mpkendall/prototype-badge/README.md

# prototype-badge
pcb badges for prototype!
