mpkendall/prototype-badge/code/cli/prototype-badge-flasher/README.md

# prototype-badge-flasher

This is a [Ratatui] app generated by the [Simple Template].

[Ratatui]: https://ratatui.rs
[Simple Template]: https://github.com/ratatui/templates/tree/main/simple

## License

Copyright (c) Max Kendall <66796793+mpkendall@users.noreply.github.com>

This project is licensed under the MIT license ([LICENSE] or <http://opensource.org/licenses/MIT>)

[LICENSE]: ./LICENSE
