mpkendall/prototype-badge/hardware/footprints/2-1734839-2.STEP

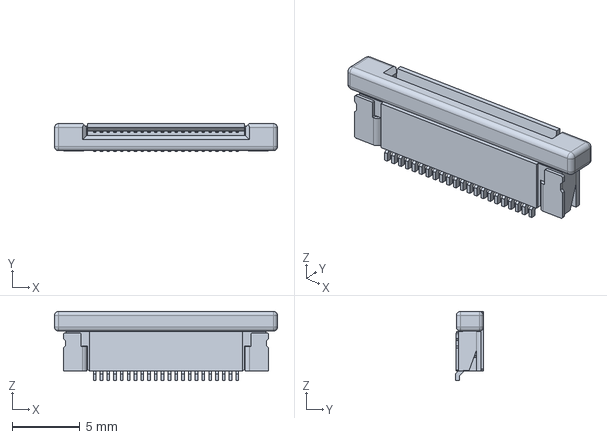
[picture p1: CAD file, 2025-12-05]
hardware/footprints/2-1734839-2.STEP
16.4 x 2.05 x 5.11 mm
