mpkendall/prototype-badge/hardware/footprints/Waveshare 1.54 E ink - Display Folded.stp

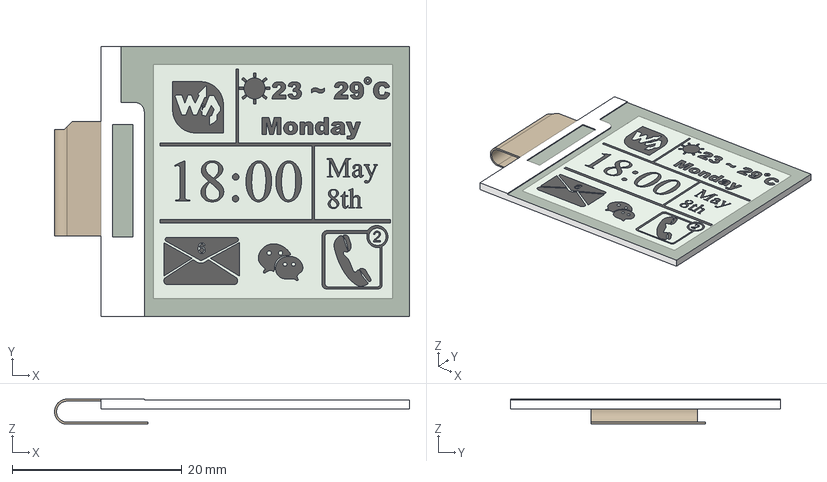
[picture p2: CAD file, 2025-12-05]
hardware/footprints/Waveshare 1.54 E ink - Display Folded.stp
41.8 x 31.8 x 2.92 mm
