mpkendall/prototype-badge/hardware/footprints/NT3H2111W0FHKH.step

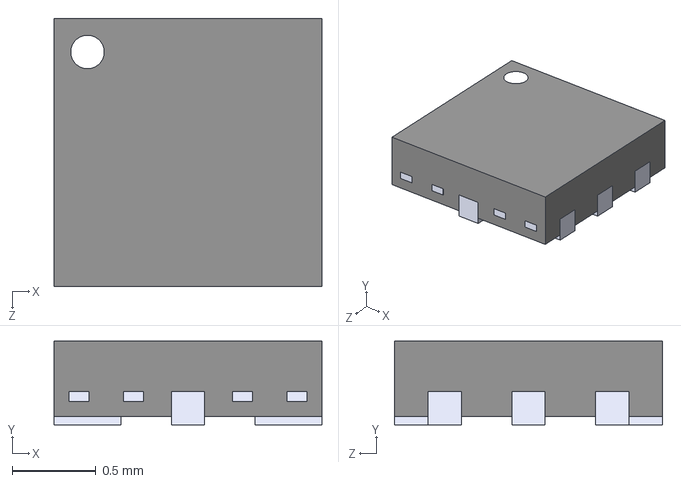
[picture p3: CAD file, 2025-11-28]
hardware/footprints/NT3H2111W0FHKH.step
1.60 x 0.5 x 1.60 mm
