mpkendall/prototype-badge/hardware/prototype-badge.kicad_pcb

## KiCad design hardware/prototype-badge.kicad_pcb (2025-12-01)

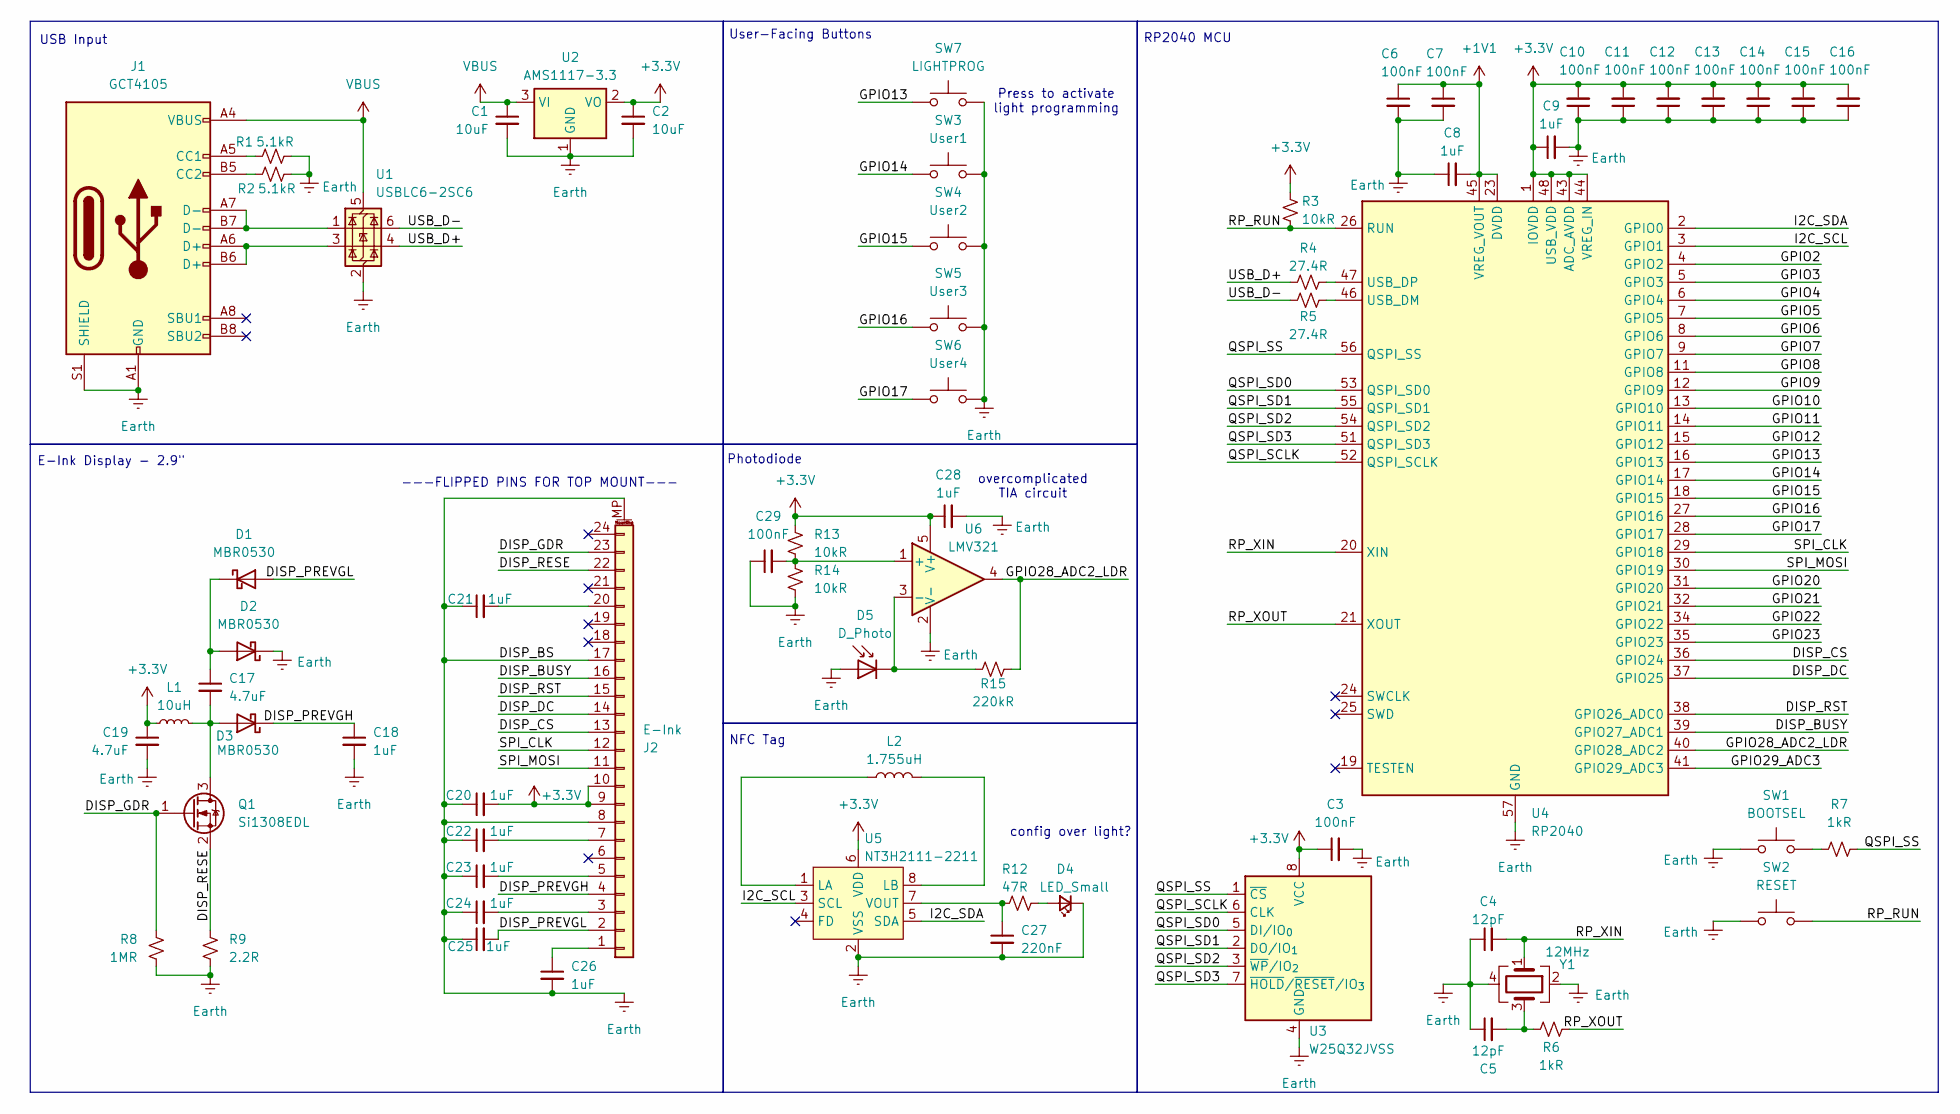
[picture p4: schematic prototype-badge.kicad_sch, Prototype PCB Badges]

Parts:
C1, C2: 10uF; C_0603_1608Metric; LCSC C19702
C3, C6, C7, C10, C11, C12, C13, C14, C15, C16, C29: 100nF; C_0402_1005Metric; LCSC C1525
C4, C5: 12pF; C_0402_1005Metric; LCSC C1547
C8, C9, C18, C20, C21, C22, C23, C24, C25, C26, C28: 1uF; C_0603_1608Metric; LCSC C15849
C17, C19: 4.7uF; C_0603_1608Metric; LCSC C69335
C27: 220nF; C_0402_1005Metric; LCSC C16772
D1, D2, D3: MBR0530; D_SOD-123; LCSC C82046
D4: LED_Small; LED_0603_1608Metric; LCSC C2286
D5: D_Photo; Kingbright_KPS-3227; LCSC C2689207
J1: GCT4105; USB_C_Receptacle_GCT_USB4105-xx-A_16P_TopMnt_Horizontal; LCSC C2760486
J2: E-Ink; TE_2-1734839-4_1x24-1MP_P0.5mm_Horizontal; LCSC C5362165
L1: 10uH; L_APV_ANR4018; LCSC C167808
L2: 1.755uH; nfc-coil-2
Q1: Si1308EDL; SOT-323_SC-70; LCSC C7603347
R1, R2: 5.1kR; R_0402_1005Metric; LCSC C25905
R3, R13, R14: 10kR; R_0402_1005Metric; LCSC C25744
R4, R5: 27.4R; R_0402_1005Metric; LCSC C274349
R6, R7: 1kR; R_0402_1005Metric; LCSC C11702
R8: 1MR; R_0603_1608Metric; LCSC C22935
R9: 2.2R; R_0603_1608Metric; LCSC C22939
R12: 47R; R_0603_1608Metric; LCSC C23182
R15: 220kR; R_0603_1608Metric; LCSC C22961
SW1: BOOTSEL; SW_Tactile_SPST_NO_Straight_CK_PTS636Sx25SMTRLFS; LCSC C318938
SW2: RESET; SW_Tactile_SPST_NO_Straight_CK_PTS636Sx25SMTRLFS; LCSC C318938
SW3: User1; SW_Tactile_SPST_NO_Straight_CK_PTS636Sx25SMTRLFS; LCSC C318938
SW4: User2; SW_Tactile_SPST_NO_Straight_CK_PTS636Sx25SMTRLFS; LCSC C318938
SW5: User3; SW_Tactile_SPST_NO_Straight_CK_PTS636Sx25SMTRLFS; LCSC C318938
SW6: User4; SW_Tactile_SPST_NO_Straight_CK_PTS636Sx25SMTRLFS; LCSC C318938
SW7: LIGHTPROG; SW_Tactile_SPST_NO_Straight_CK_PTS636Sx25SMTRLFS; LCSC C318938
U1: USBLC6-2SC6; SOT-23-6; LCSC C7519
U2: AMS1117-3.3; SOT-223-3_TabPin2; LCSC C18906017
U3: W25Q32JVSS; SOIC-8_5.3x5.3mm_P1.27mm; LCSC C97521
U4: RP2040; QFN-56-1EP_7x7mm_P0.4mm_EP3.2x3.2mm; LCSC C2040
U5: NT3H2111-2211; NT3H2111W0FHKH; LCSC C710403
U6: LMV321; SOT-23-5; LCSC C7972
Y1: 12MHz; Crystal_SMD_3225-4Pin_3.2x2.5mm; LCSC C37635368

Connections:
+1V1: C6.1, C7.1, C8.2, U4.23 (DVDD), U4.45 (VREG_VOUT), U4.50 (DVDD)
+3.3V: C2.1, C3.1, C9.1, C10.2, C11.2, C12.2, C13.2, C14.2, C15.2, C16.2, C19.1, C20.2, C28.1, J2.9, J2.10, L1.1, R3.1, R13.1, U2.2 (VO), U3.8 (VCC), U4.1 (IOVDD), U4.10 (IOVDD), U4.22 (IOVDD), U4.33 (IOVDD), U4.42 (IOVDD), U4.43 (ADC_AVDD), U4.44 (VREG_IN), U4.48 (USB_VDD), U4.49 (IOVDD), U5.6 (VDD), U6.5 (V+)
/DISP_BUSY: J2.16, U4.39 (GPIO27_ADC1)
/DISP_CS: J2.13, U4.36 (GPIO24)
/DISP_DC: J2.14, U4.37 (GPIO25)
/DISP_GDR: J2.23, Q1.1 (G), R8.2
/DISP_PREVGH: C18.1, D3.1 (K), J2.4
/DISP_PREVGL: C25.2, D1.2 (A), J2.2
/DISP_RESE: J2.22, Q1.2 (S), R9.1
/DISP_RST: J2.15, U4.38 (GPIO26_ADC0)
/GPIO2: U4.4 (GPIO2)
/GPIO3: U4.5 (GPIO3)
/GPIO4: U4.6 (GPIO4)
/GPIO5: U4.7 (GPIO5)
/GPIO6: U4.8 (GPIO6)
/GPIO7: U4.9 (GPIO7)
/GPIO8: U4.11 (GPIO8)
/GPIO9: U4.12 (GPIO9)
/GPIO10: U4.13 (GPIO10)
/GPIO11: U4.14 (GPIO11)
/GPIO12: U4.15 (GPIO12)
/GPIO13: SW7.1, U4.16 (GPIO13)
/GPIO14: SW3.1, U4.17 (GPIO14)
/GPIO15: SW4.1, U4.18 (GPIO15)
/GPIO16: SW5.1, U4.27 (GPIO16)
/GPIO17: SW6.1, U4.28 (GPIO17)
/GPIO20: U4.31 (GPIO20)
/GPIO21: U4.32 (GPIO21)
/GPIO22: U4.34 (GPIO22)
/GPIO23: U4.35 (GPIO23)
/GPIO28_ADC2_LDR: R15.1, U4.40 (GPIO28_ADC2), U6.4
/GPIO29_ADC3: U4.41 (GPIO29_ADC3)
/I2C_SCL: U4.3 (GPIO1), U5.3 (SCL)
/I2C_SDA: U4.2 (GPIO0), U5.5 (SDA)
/QSPI_SCLK: U3.6 (CLK), U4.52 (QSPI_SCLK)
/QSPI_SD0: U3.5 (DI/IO_{0}), U4.53 (QSPI_SD0)
/QSPI_SD1: U3.2 (DO/IO_{1}), U4.55 (QSPI_SD1)
/QSPI_SD2: U3.3 (~WP/IO_{2}), U4.54 (QSPI_SD2)
/QSPI_SD3: U3.7 (~HOLD/~RESET/IO_{3}), U4.51 (QSPI_SD3)
/QSPI_SS: R7.2, U3.1 (~CS), U4.56 (QSPI_SS)
/RP_RUN: R3.2, SW2.2, U4.26 (RUN)
/RP_XIN: C4.2, U4.20 (XIN), Y1.1
/RP_XOUT: R6.1, U4.21 (XOUT)
/SPI_CLK: J2.12, U4.29 (GPIO18)
/SPI_MOSI: J2.11, U4.30 (GPIO19)
/USB_D+: R4.1, U1.4 (I/O2)
/USB_D-: R5.2, U1.6 (I/O1)
Earth: C1.2, C2.2, C3.2, C4.1, C5.1, C6.2, C7.2, C8.1, C9.2, C10.1, C11.1, C12.1, C13.1, C14.1, C15.1, C16.1, C18.2, C19.2, C20.1, C21.1, C22.1, C23.1, C24.1, C25.1, C26.2, C27.2, C28.2, C29.1, D2.1 (K), D4.1 (K), D5.2 (A), J1.A1 (GND), J1.A12 (GND), J1.B1 (GND), J1.B12 (GND), J1.S1 (SHIELD), J2.8, J2.17, J2.MP (MountPin), R1.1, R2.2, R8.1, R9.2, R14.2, SW1.1, SW2.1, SW3.2, SW4.2, SW5.2, SW6.2, SW7.2, U1.2 (GND), U2.1 (GND), U3.4 (GND), U4.57 (GND), U5.2 (VSS), U6.2 (V-), Y1.2, Y1.4
unnamed: C5.2, R6.2, Y1.3
unnamed: C17.1, D1.1 (K), D2.2 (A)
unnamed: C17.2, D3.2 (A), L1.2, Q1.3 (D)
unnamed: D4.2 (A), R12.2
unnamed: D5.1 (K), R15.2, U6.3 (-)
unnamed: J1.A5 (CC1), R1.2
unnamed: J1.B5 (CC2), R2.1
unnamed: J1.A6 (D+), J1.B6 (D+), U1.3 (I/O2)
unnamed: J1.A7 (D-), J1.B7 (D-), U1.1 (I/O1)
unnamed: C26.1, J2.1
unnamed: C24.2, J2.3
unnamed: C23.2, J2.5
unnamed: C22.2, J2.7
unnamed: C21.2, J2.20
unnamed: R7.1, SW1.2
unnamed: R5.1, U4.46 (USB_DM)
unnamed: R4.2, U4.47 (USB_DP)
unnamed: L2.1, U5.1 (LA)
unnamed: L2.2, U5.8 (LB)
unnamed: C27.1, R12.1, U5.7 (VOUT)
unnamed: C29.2, R13.2, R14.1, U6.1 (+)
VBUS: C1.1, J1.A4 (VBUS), J1.A9 (VBUS), J1.B4 (VBUS), J1.B9 (VBUS), U1.5 (VBUS), U2.3 (VI)

Notes on the sheet:
User-Facing Buttons
---FLIPPED PINS FOR TOP MOUNT---
Photodiode
Press to activate light programming
E-Ink Display - 2.9"
NFC Tag
USB Input
RP2040 MCU
overcomplicated TIA circuit
config over light?

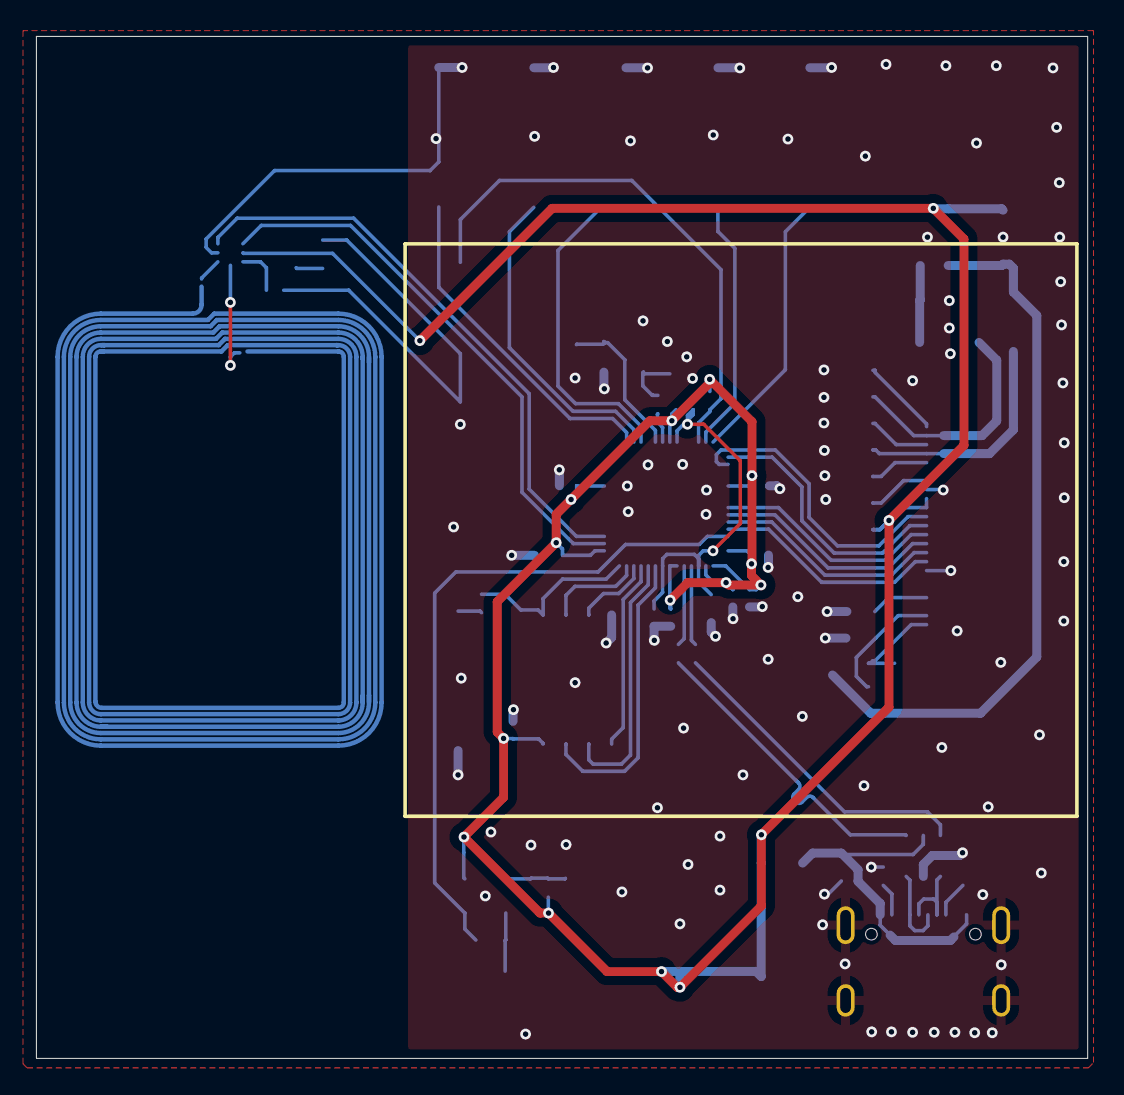
[picture p5: board prototype-badge.kicad_pcb from above]

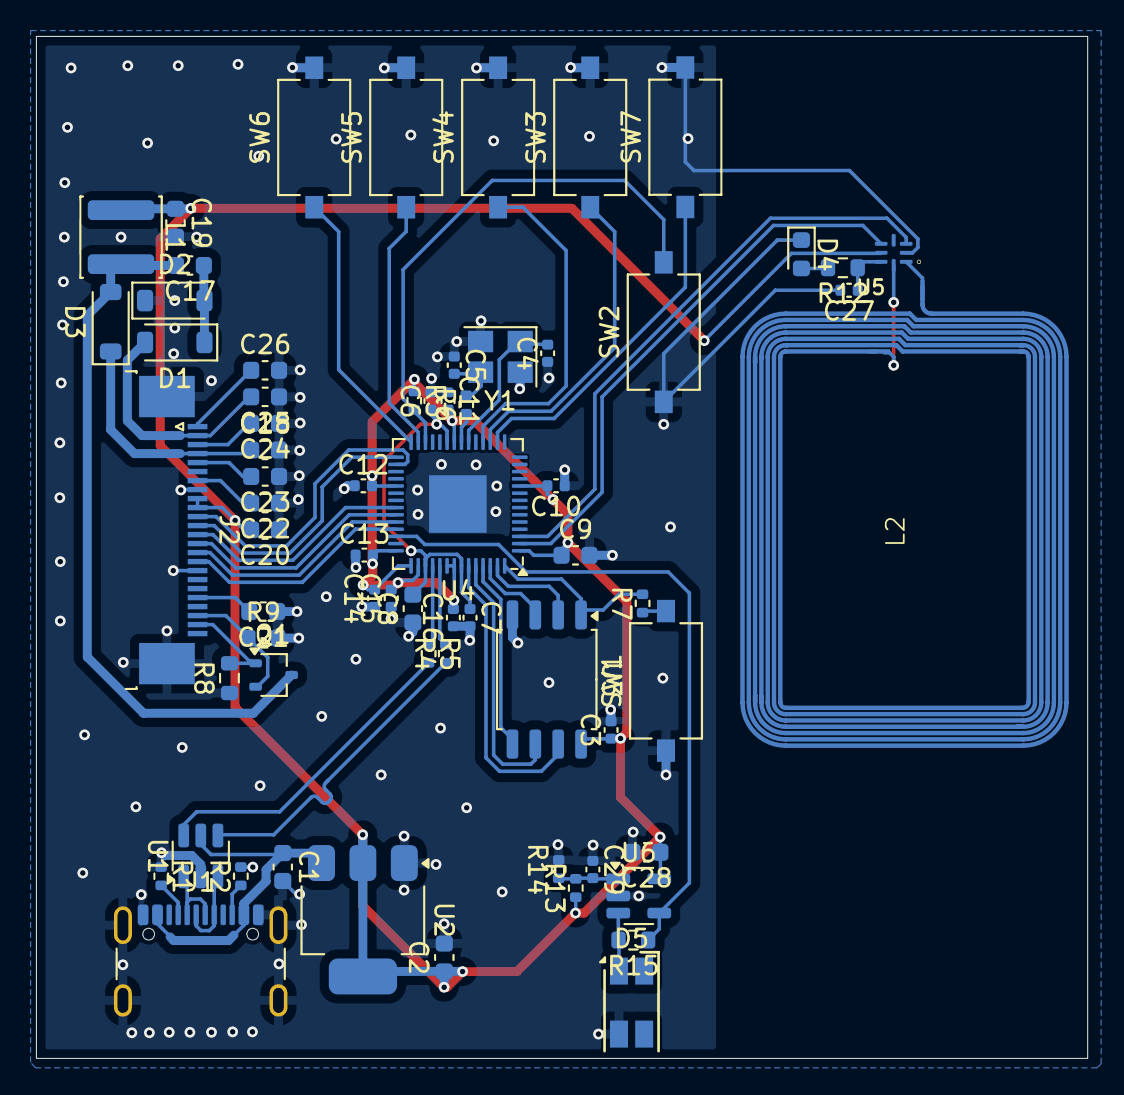
[picture p6: board prototype-badge.kicad_pcb from below]

Board: 2 copper layers, 58.4 x 56.8 mm, 66 parts (66 on the bottom side), 54 nets.
