mpkendall/prototype-badge/(commit log)

2025-11-26 base mcu schematic
    [prototype-badge.kicad_pcb, prototype-badge.kicad_sch]
2025-11-28 started pcb
    [NT3H2111W0FHKH.step, prototype-badge.kicad_pcb, prototype-badge.kicad_sch]
2025-12-01 90% done with pcb, need to add dev pins
    [prototype-badge.kicad_pcb, prototype-badge.kicad_sch]
2025-12-02 added gpio pins - next up: finalize outline (add fpc connector + corners), add art
    [prototype-badge.kicad_sch]
2025-12-03 v2 - new layout and reworked routing
    [prototype-badge.kicad_sch]
2025-12-05 release candidate 1 :eyes-shaking:
    [2-1734839-2.STEP, Waveshare 1.54 E ink - Display Folded.stp]
2025-12-05 prod files!
    [prototype-badge-centroid.csv, prototype-badge.csv, prototype-badge.kicad_sch]
2025-12-14 working badge app! still need to add photodiode stuff. config save also resets badge now
    [display.py, einkdriver.py, main.py, microfont.py]
2025-12-14 fix logging and add untested photodiode code
    [main.py]
2025-12-19 fix bug on mac
    [main.rs]
2025-12-19 tab to switch
2025-12-19 fixed merge conflict, shouldnt change anything?
    [main.rs]
2025-12-19 Added rotate method to display to fix orientation of badges
    [display.py, main.py]
2025-12-19 experimental nfc driver
2025-12-19 Enhance NFC read/write methods for improved I2C compatibility
